botson17/WRO-2026-Future-Engineers/schemes/Concept.png

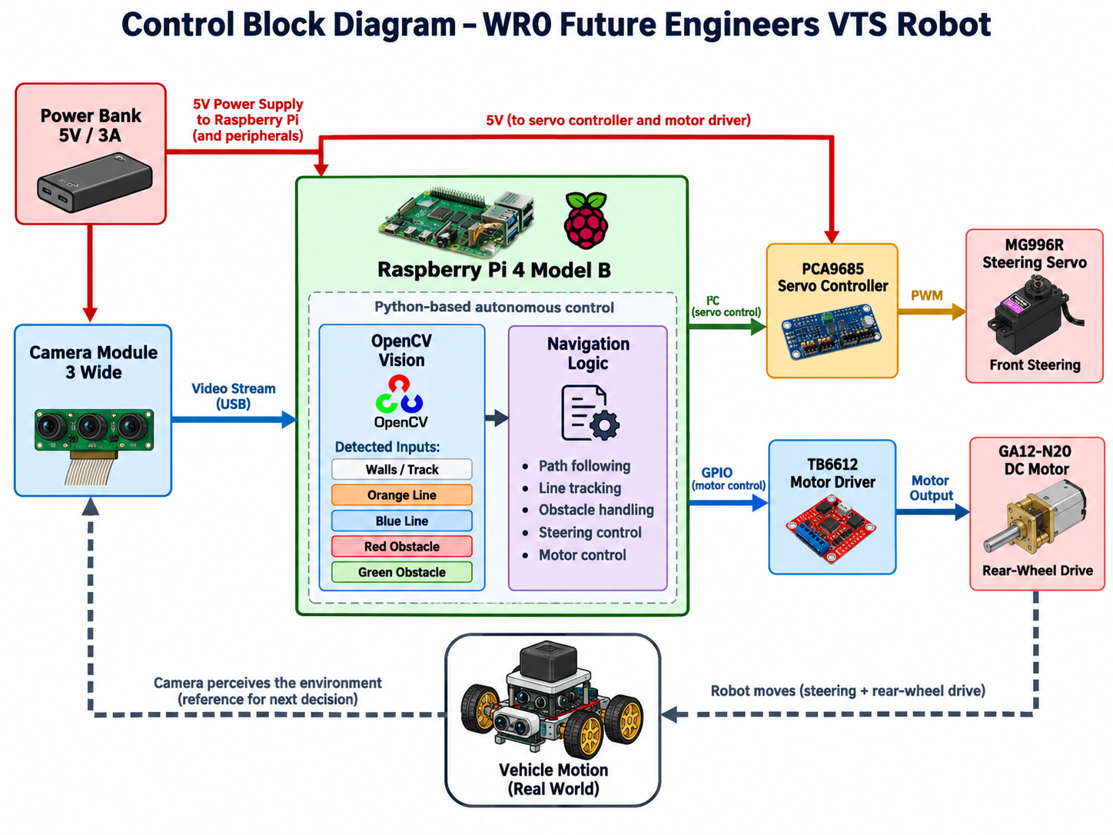
schemes/Concept.png
