botson17/WRO-2026-Future-Engineers/schemes/Drive logic.png

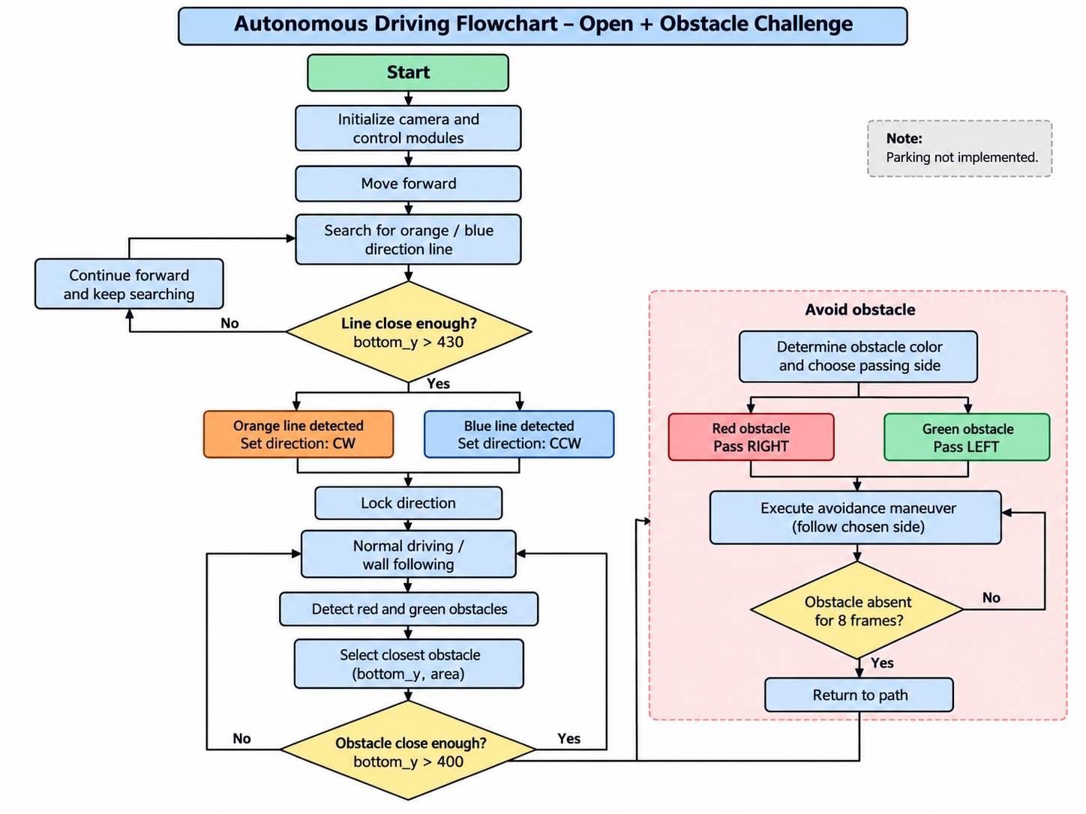
schemes/Drive logic.png
