botson17/WRO-2026-Future-Engineers/schemes/Wireing diagram.png

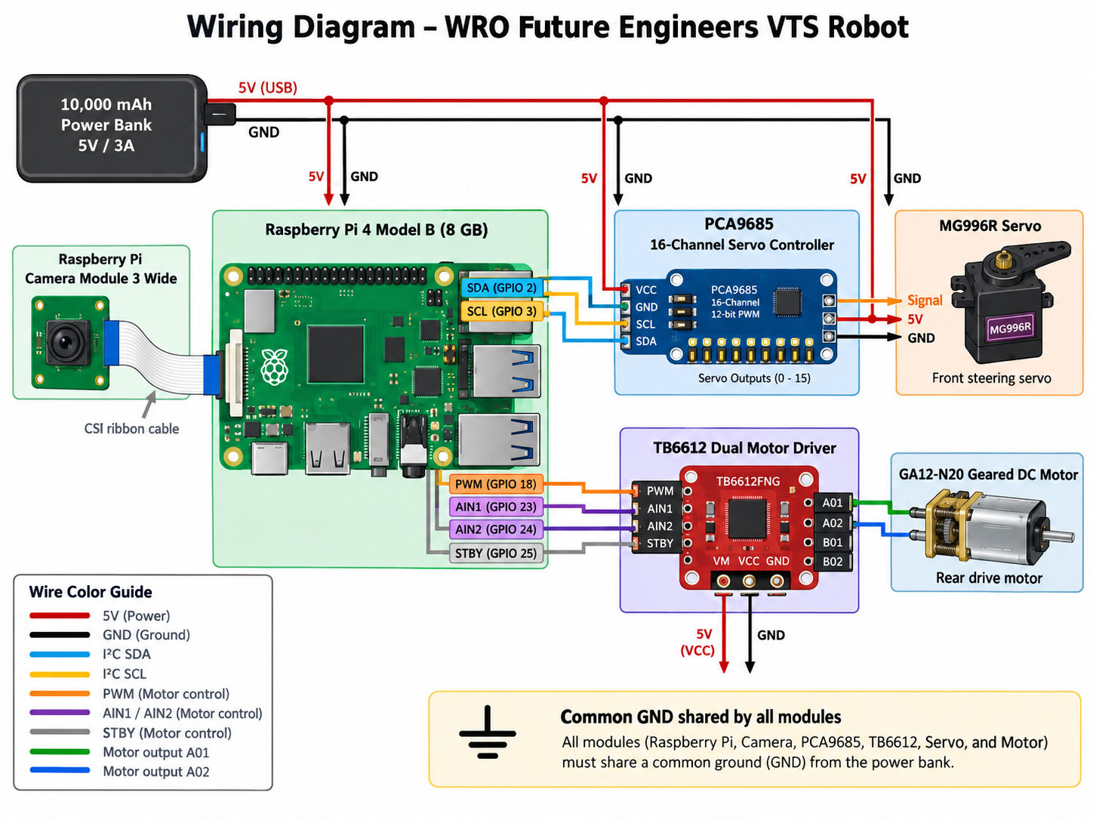
schemes/Wireing diagram.png
