botson17/WRO-2026-Future-Engineers/t-photos/Szemfényvesztők Funny Photo.png

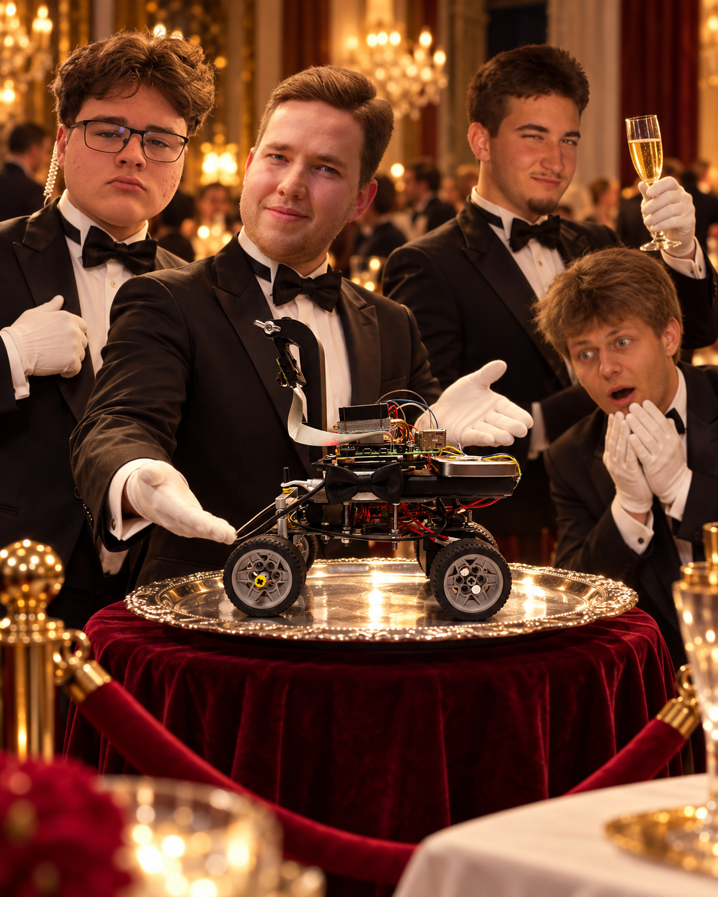
t-photos/Szemfényvesztők Funny Photo.png
