botson17/WRO-2026-Future-Engineers/v-photos/1.jpg

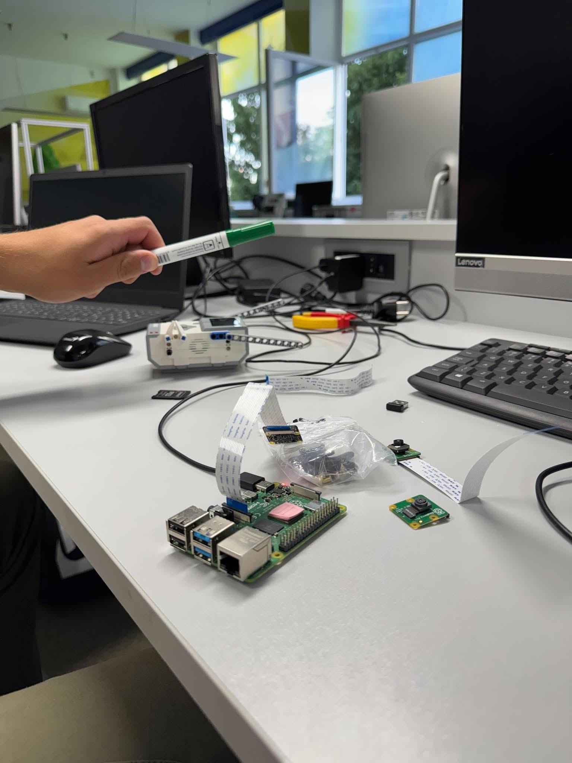
v-photos/1.jpg
