botson17/WRO-2026-Future-Engineers/v-photos/2.jpg

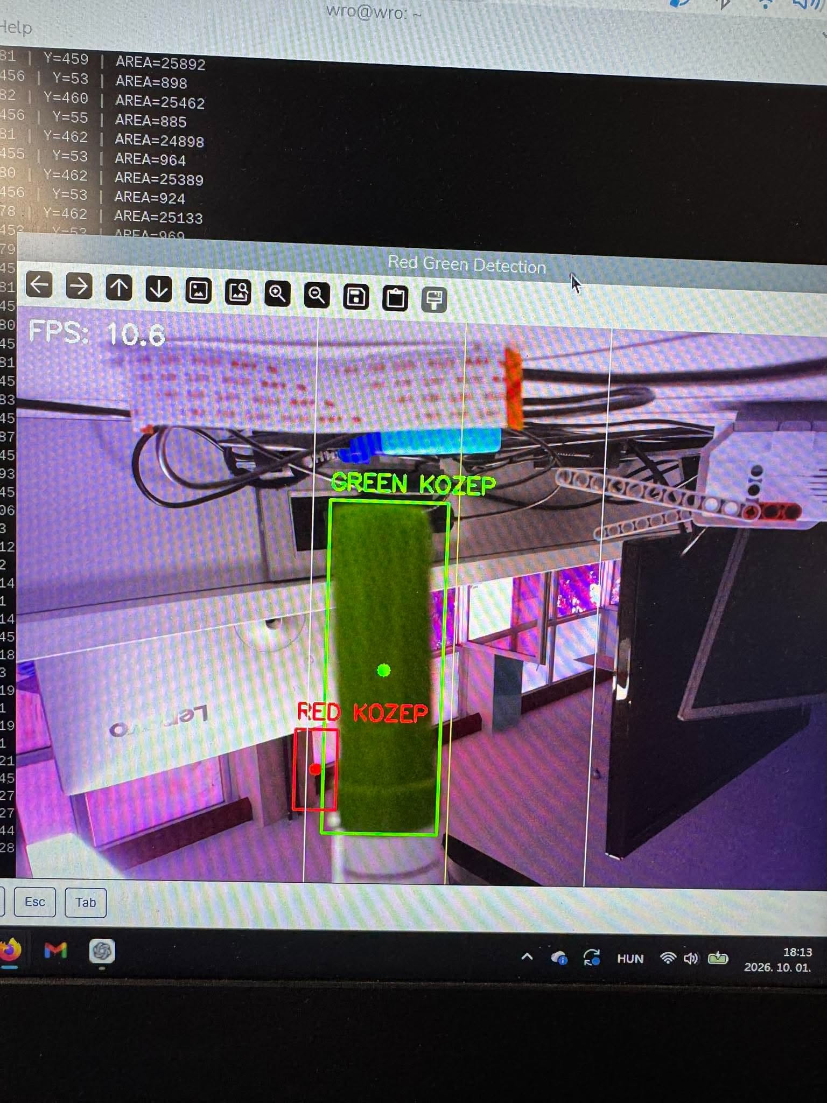
v-photos/2.jpg
