botson17/WRO-2026-Future-Engineers/v-photos/3.jpg

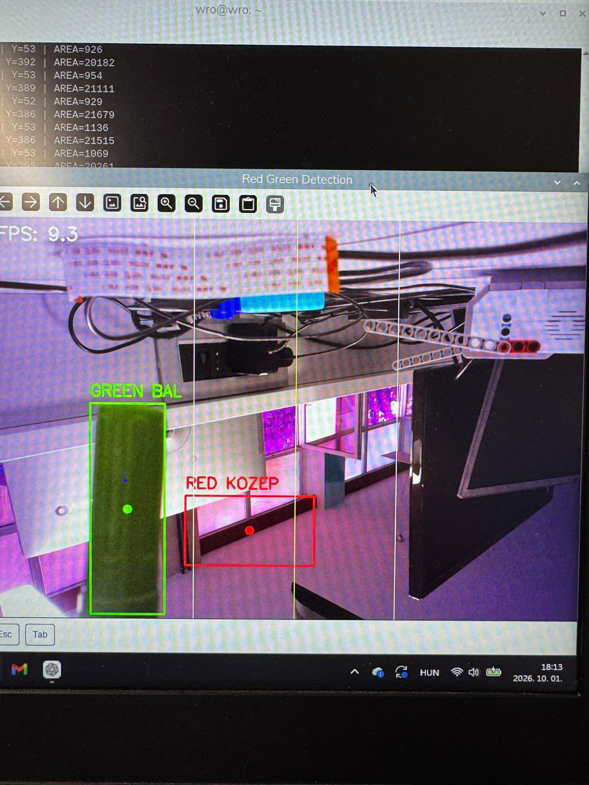
v-photos/3.jpg
