botson17/WRO-2026-Future-Engineers/v-photos/4.jpg

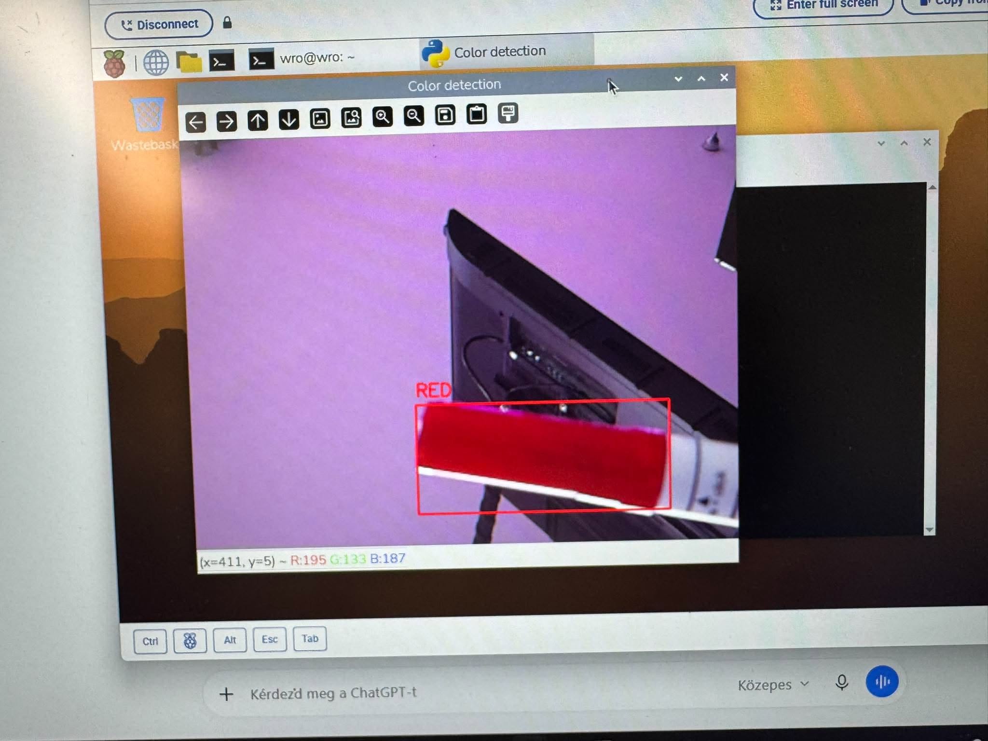
v-photos/4.jpg
