botson17/WRO-2026-Future-Engineers/v-photos/5.jpg

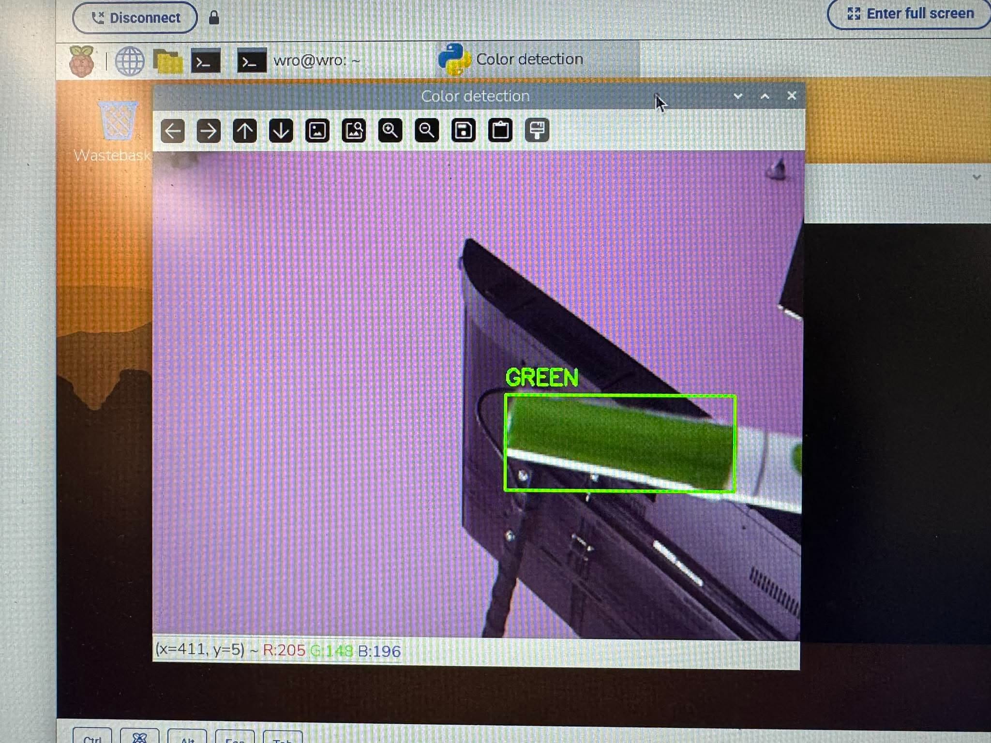
v-photos/5.jpg
