botson17/WRO-2026-Future-Engineers/v-photos/6.jpg

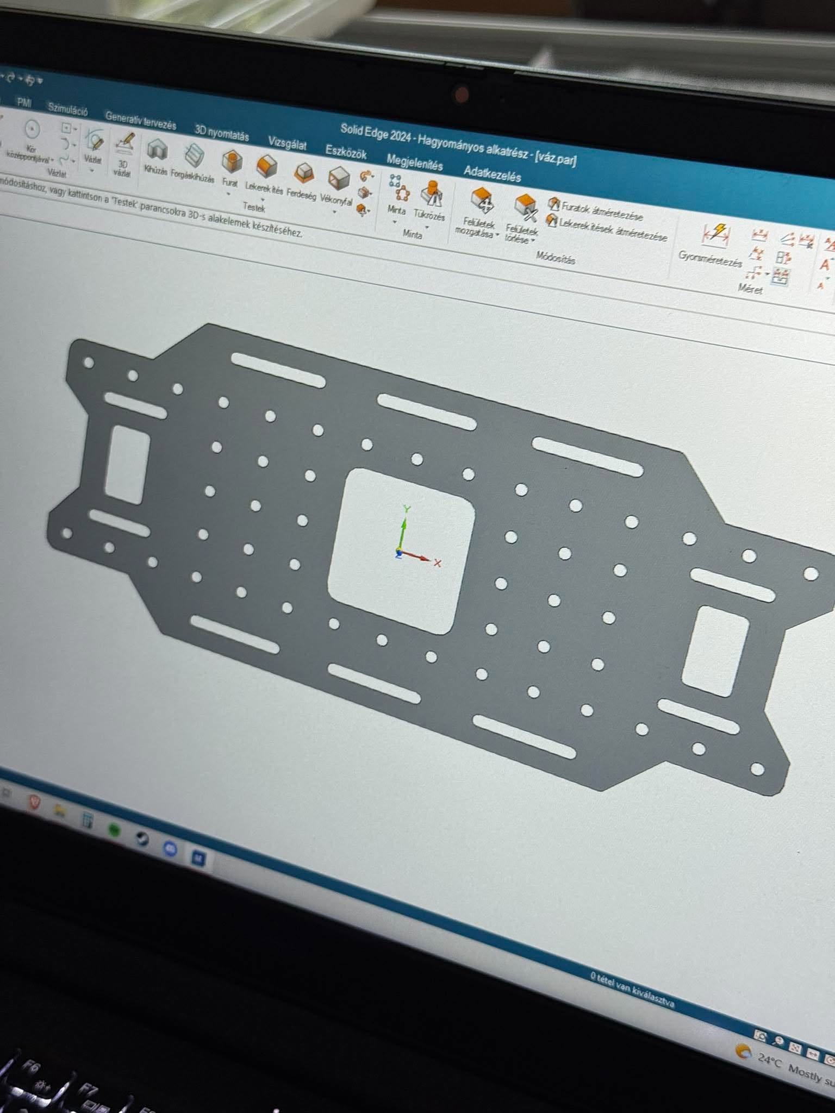
v-photos/6.jpg
