botson17/WRO-2026-Future-Engineers/v-photos/7.jpg

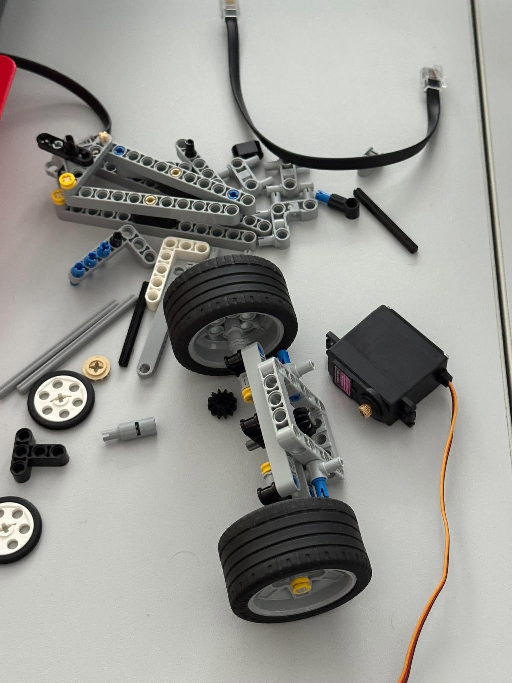
v-photos/7.jpg
