botson17/WRO-2026-Future-Engineers/v-photos/8.jpg

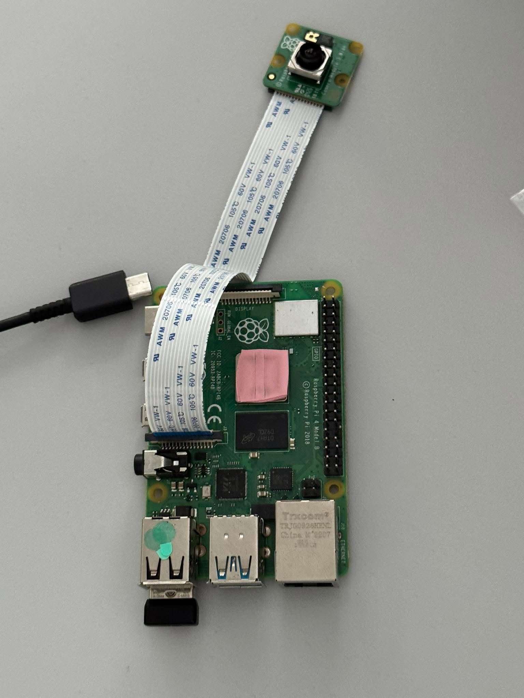
v-photos/8.jpg
