botson17/WRO-2026-Future-Engineers/v-photos/robot back.jpeg

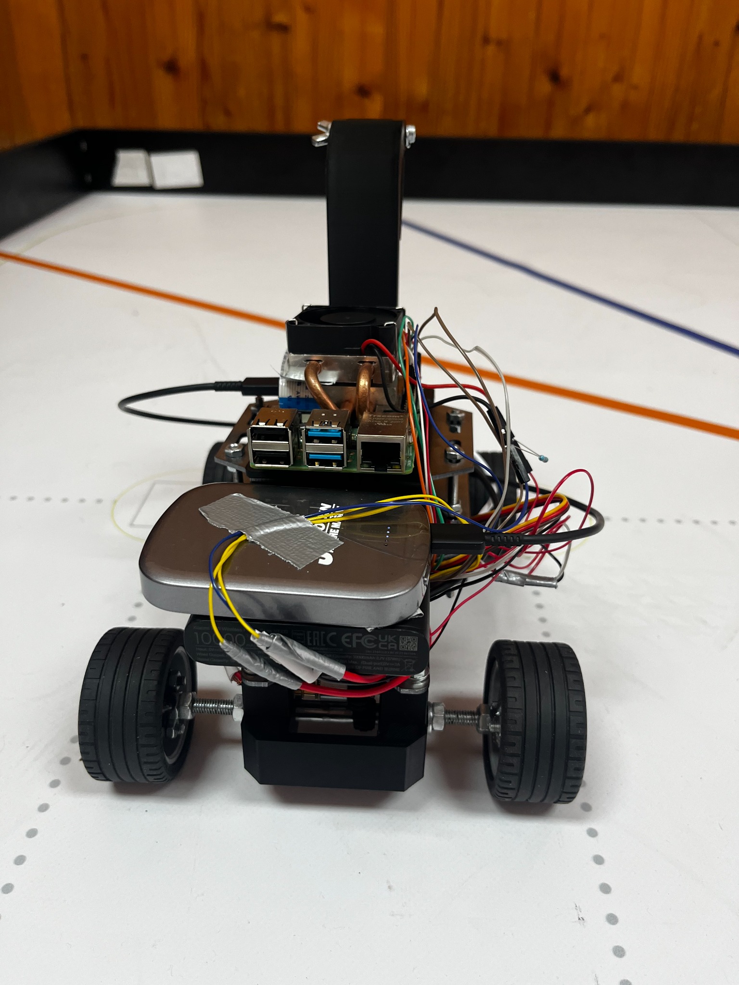
v-photos/robot back.jpeg
