botson17/WRO-2026-Future-Engineers/v-photos/robot bottom.jpeg

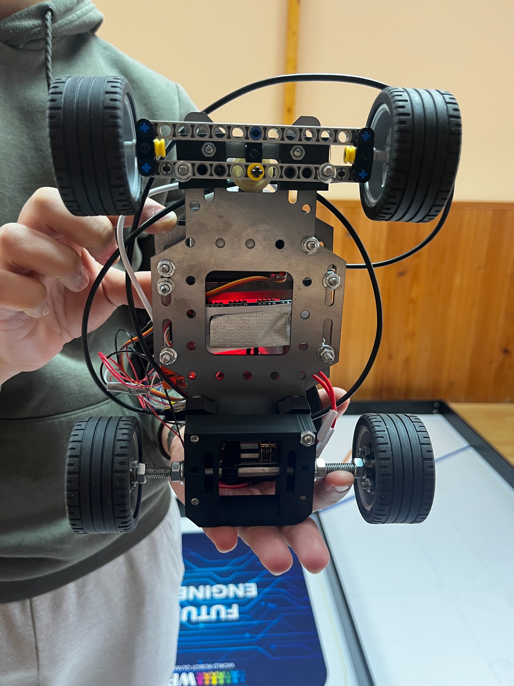
v-photos/robot bottom.jpeg
