botson17/WRO-2026-Future-Engineers/v-photos/robot front.jpeg

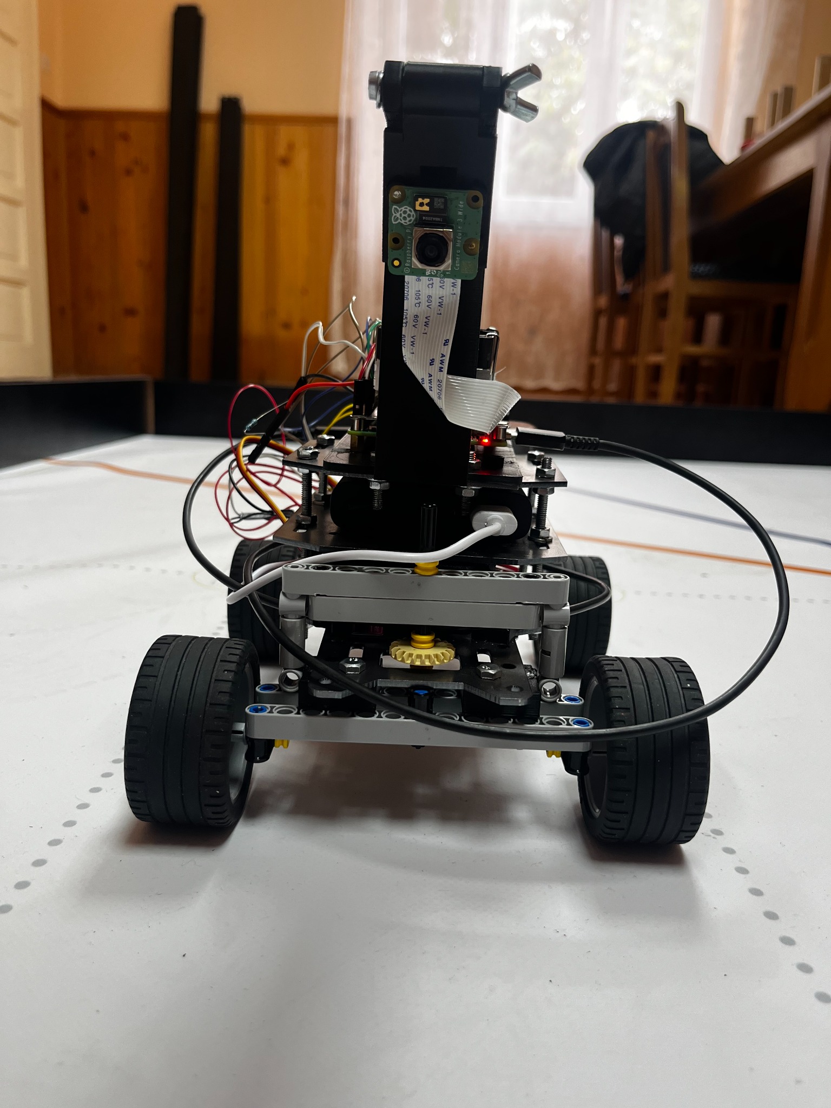
v-photos/robot front.jpeg
