botson17/WRO-2026-Future-Engineers/v-photos/robot left.jpeg

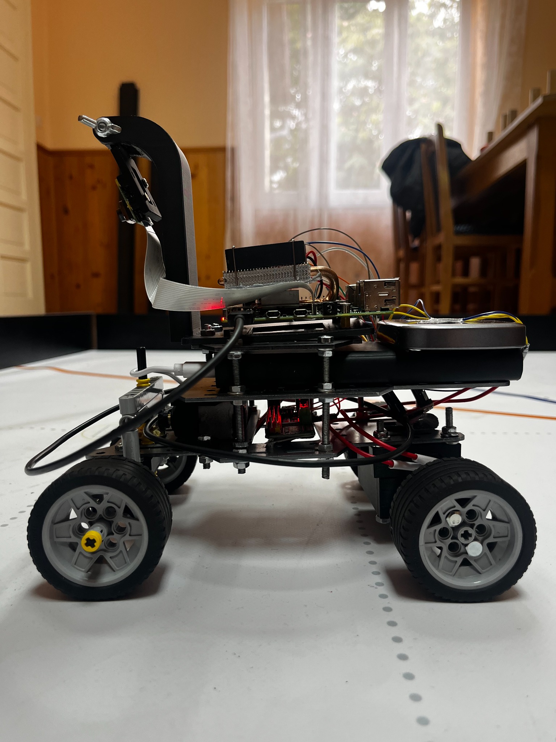
v-photos/robot left.jpeg
