botson17/WRO-2026-Future-Engineers/v-photos/robot right.jpeg

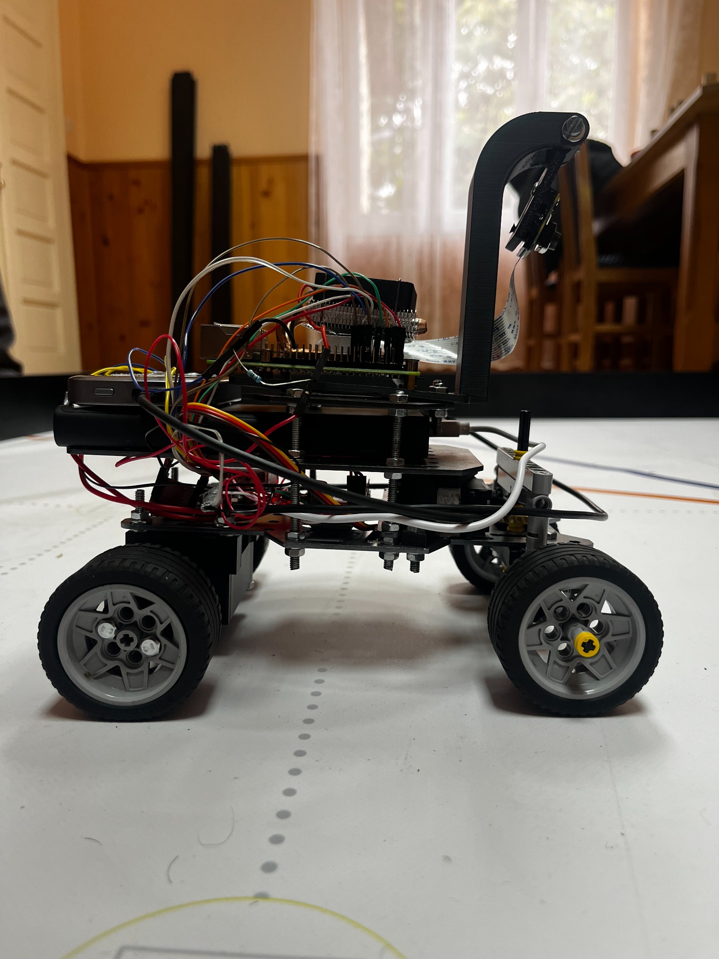
v-photos/robot right.jpeg
