botson17/WRO-2026-Future-Engineers/v-photos/robot top.jpeg

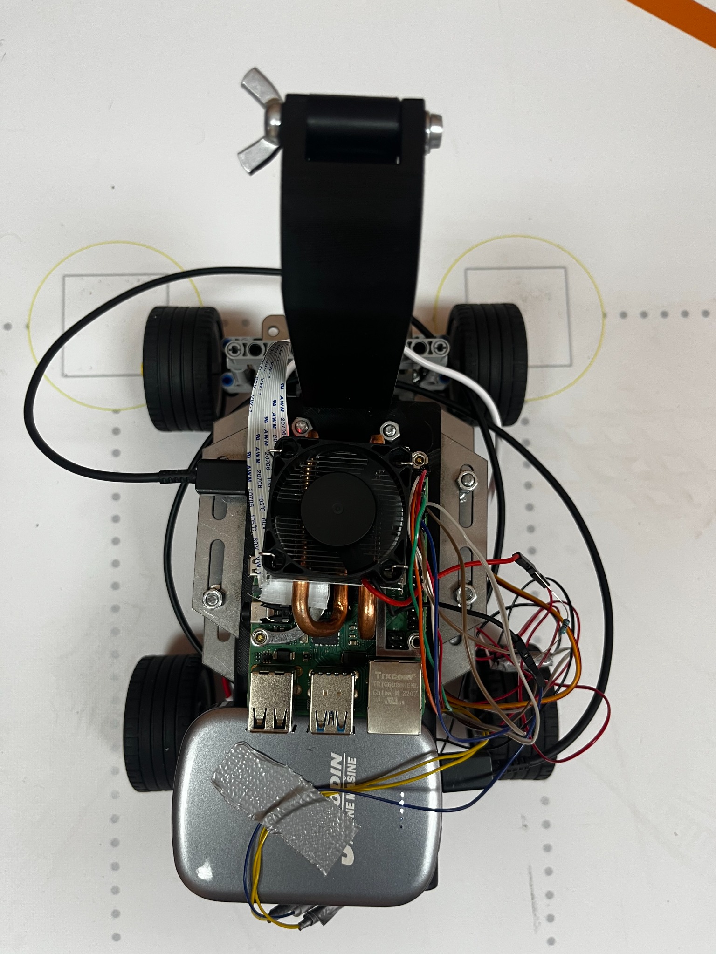
v-photos/robot top.jpeg
