botson17/WRO-2026-Future-Engineers/models/12 Tooth Bevel Gear for DC Motor.stl

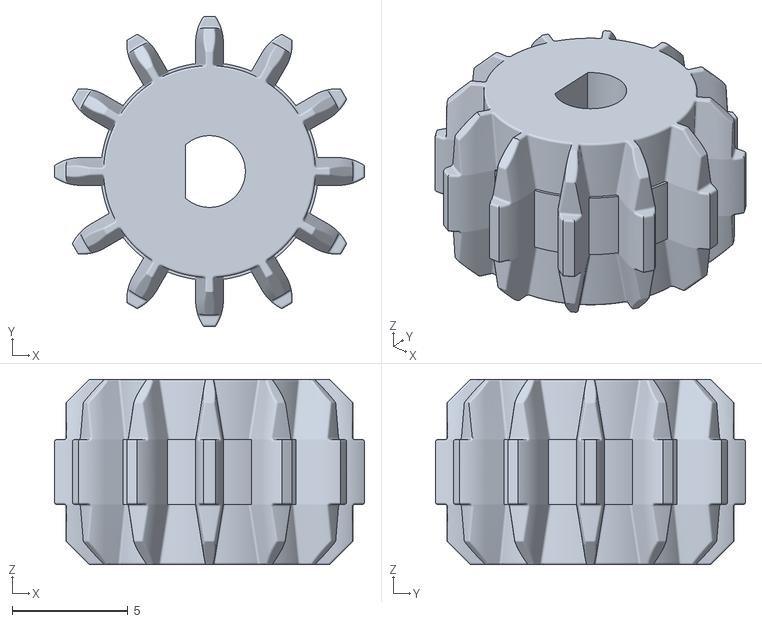
[picture p27: CAD file, 2026-10-02, last stored version]
models/12 Tooth Bevel Gear for DC Motor.stl
13.4 x 13.4 x 8.00
