botson17/WRO-2026-Future-Engineers/models/Chassis.stl

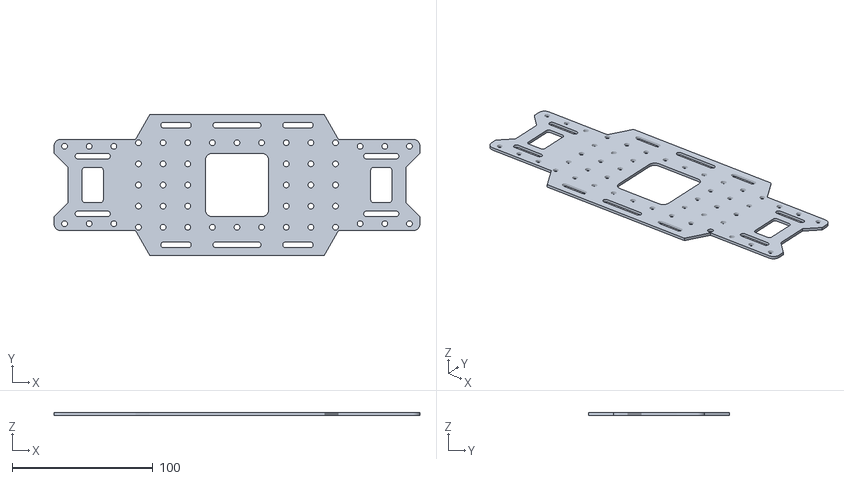
[picture p28: CAD file, 2026-10-02, last stored version]
models/Chassis.stl
260.0 x 100.0 x 2.00
