botson17/WRO-2026-Future-Engineers/(commit log)

2026-09-24 Add docs/power-and-sensors.md for WRO 2026 project documentation
2026-10-02 Testing a Raspberry Pi setup with camera modules and connected hardware components during development.
2026-10-02 Real-time red and green object detection using a camera feed with bounding boxes and position tracking.
2026-10-02 Real-time detection of red and green zones with camera-based color recognition and position tracking.
2026-10-02 Real-time red object detection using camera-based color recognition and bounding box tracking.
2026-10-02 Real-time green object detection using camera-based color recognition and bounding box tracking.
2026-10-02 CAD design of the robot chassis with mounting holes and slots for mechanical and electronic components.
2026-10-02 Steering mechanism assembled from LEGO Technic components.
2026-10-02 Raspberry Pi 4 connected to a camera module for image processing and computer vision testing.
2026-10-02 First assembly
